MusaMahmood/KiCAD-EEG-INA828-nRF52/EEG_ADS1299.kicad_pcb

## KiCad design EEG_ADS1299.kicad_pcb (2018-03-07)

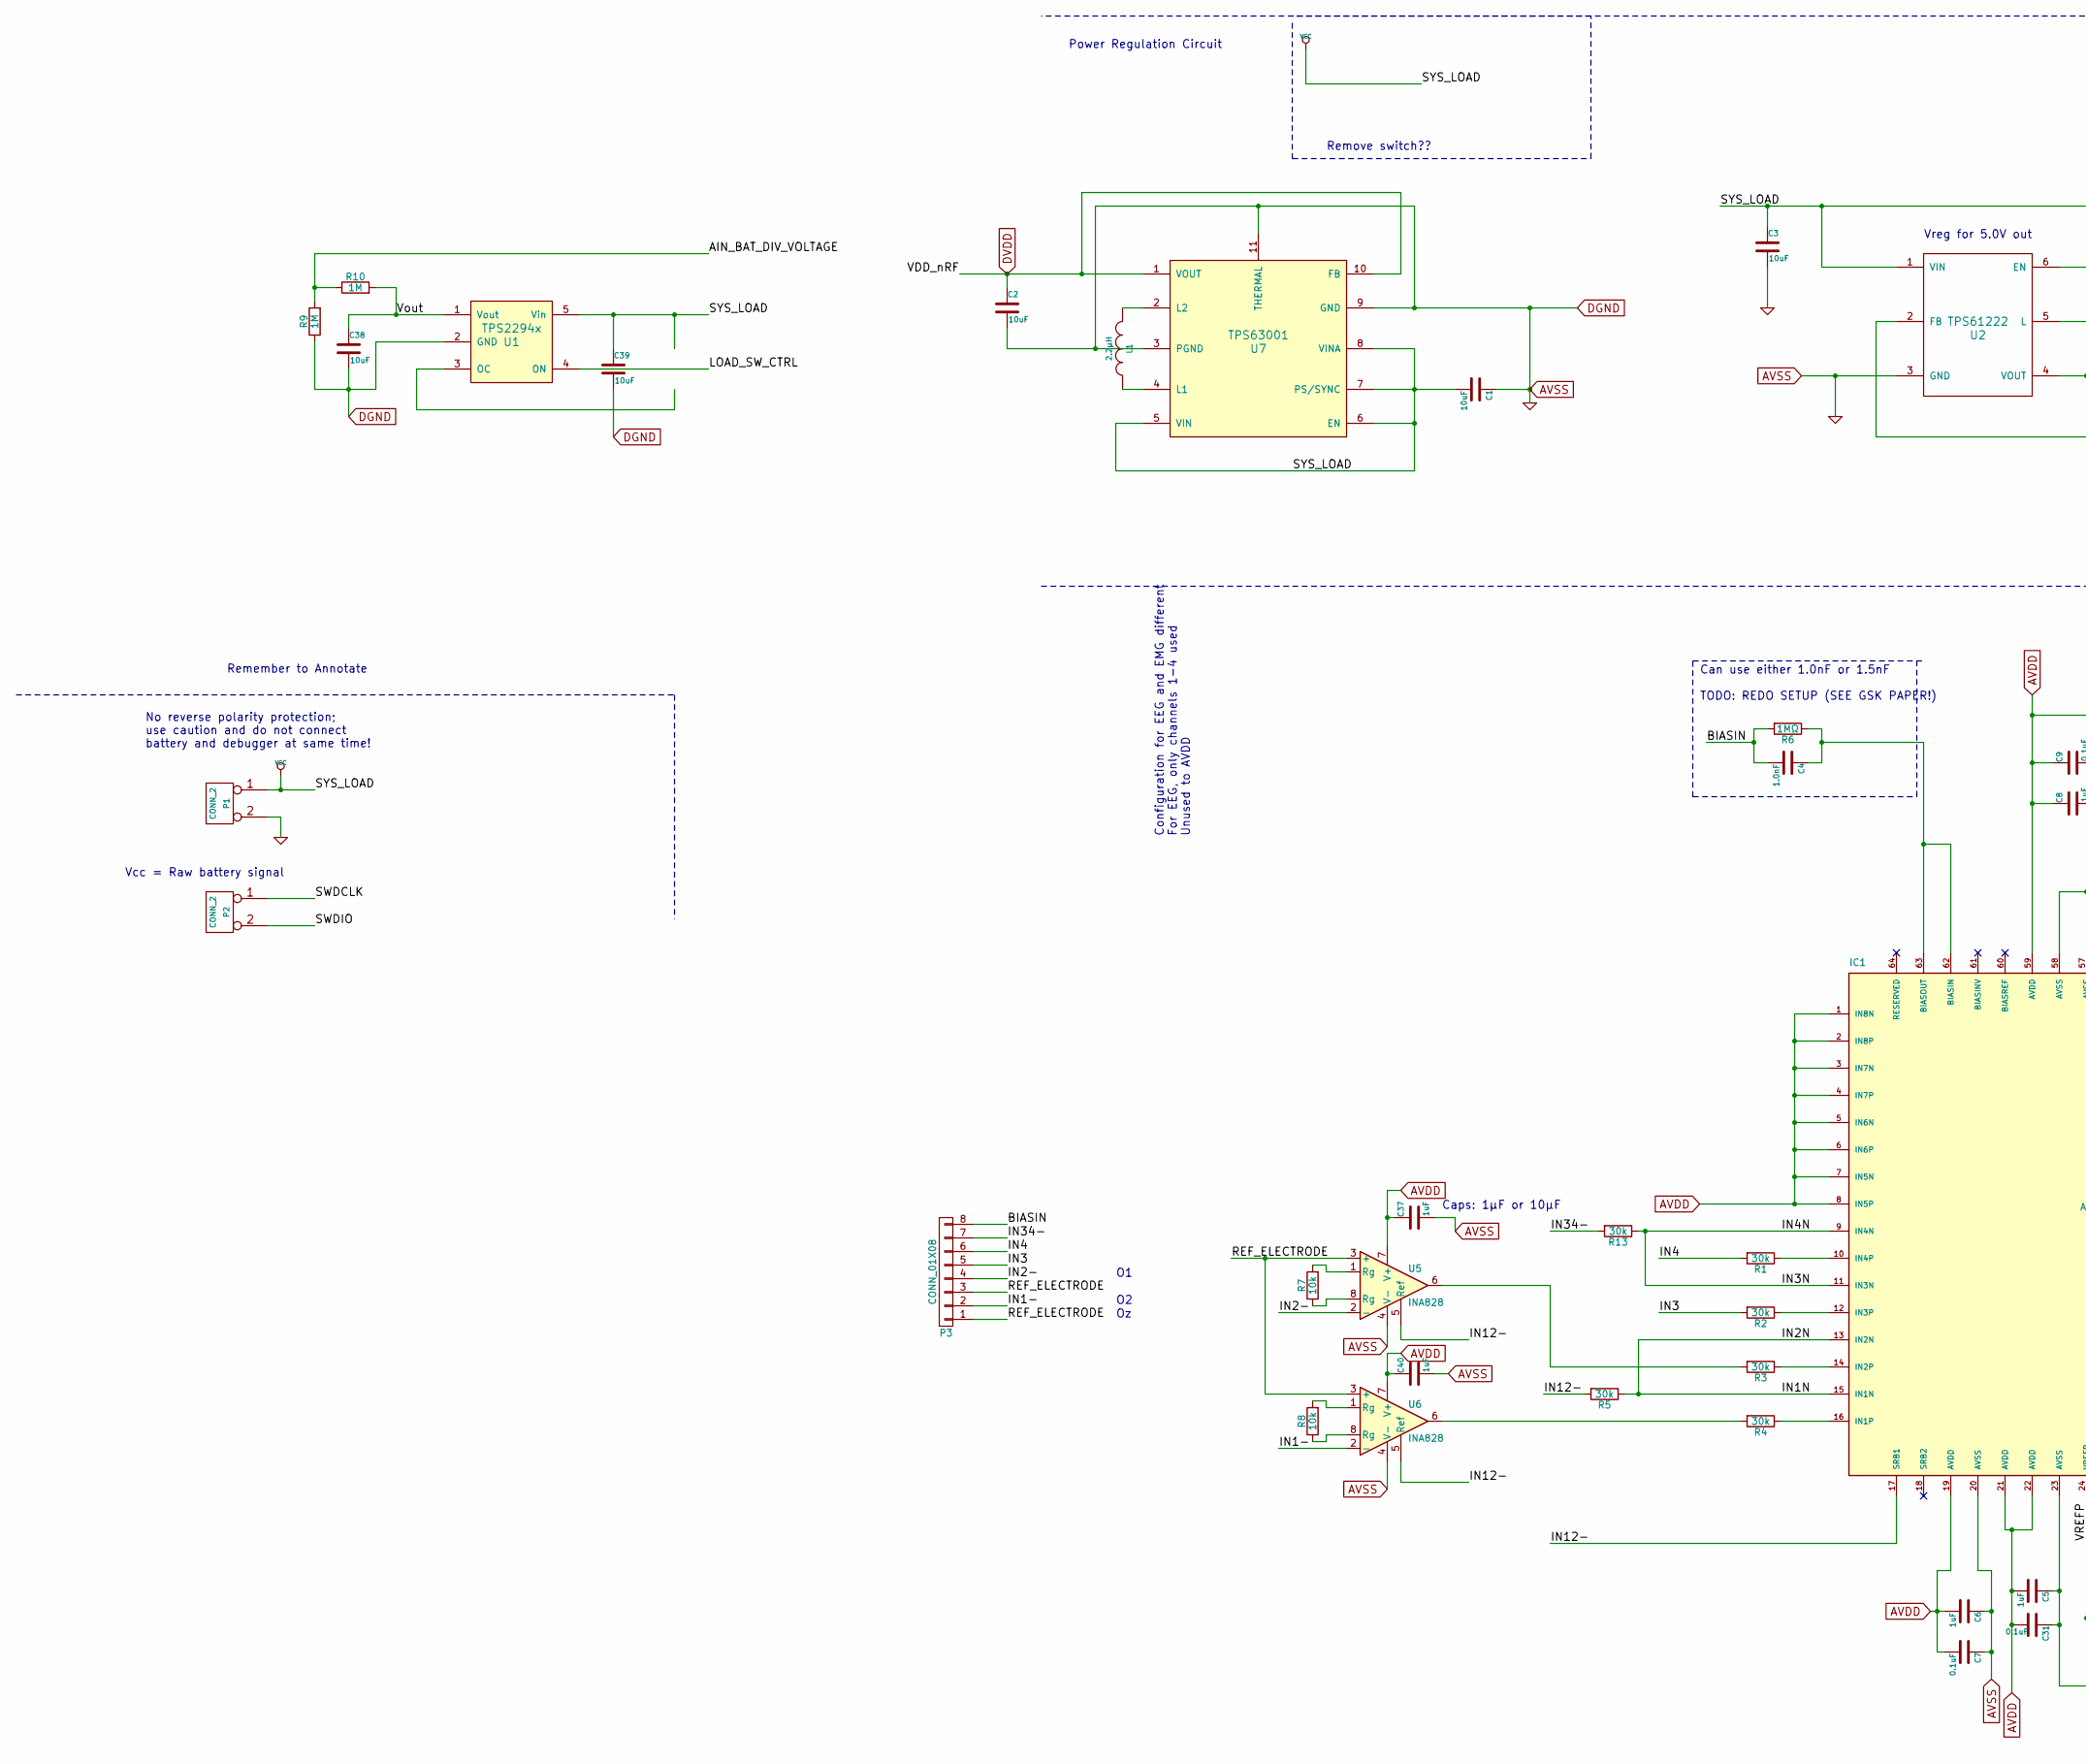
[picture p1: schematic EEG_ADS1299.sch, part in row 1, column 1]

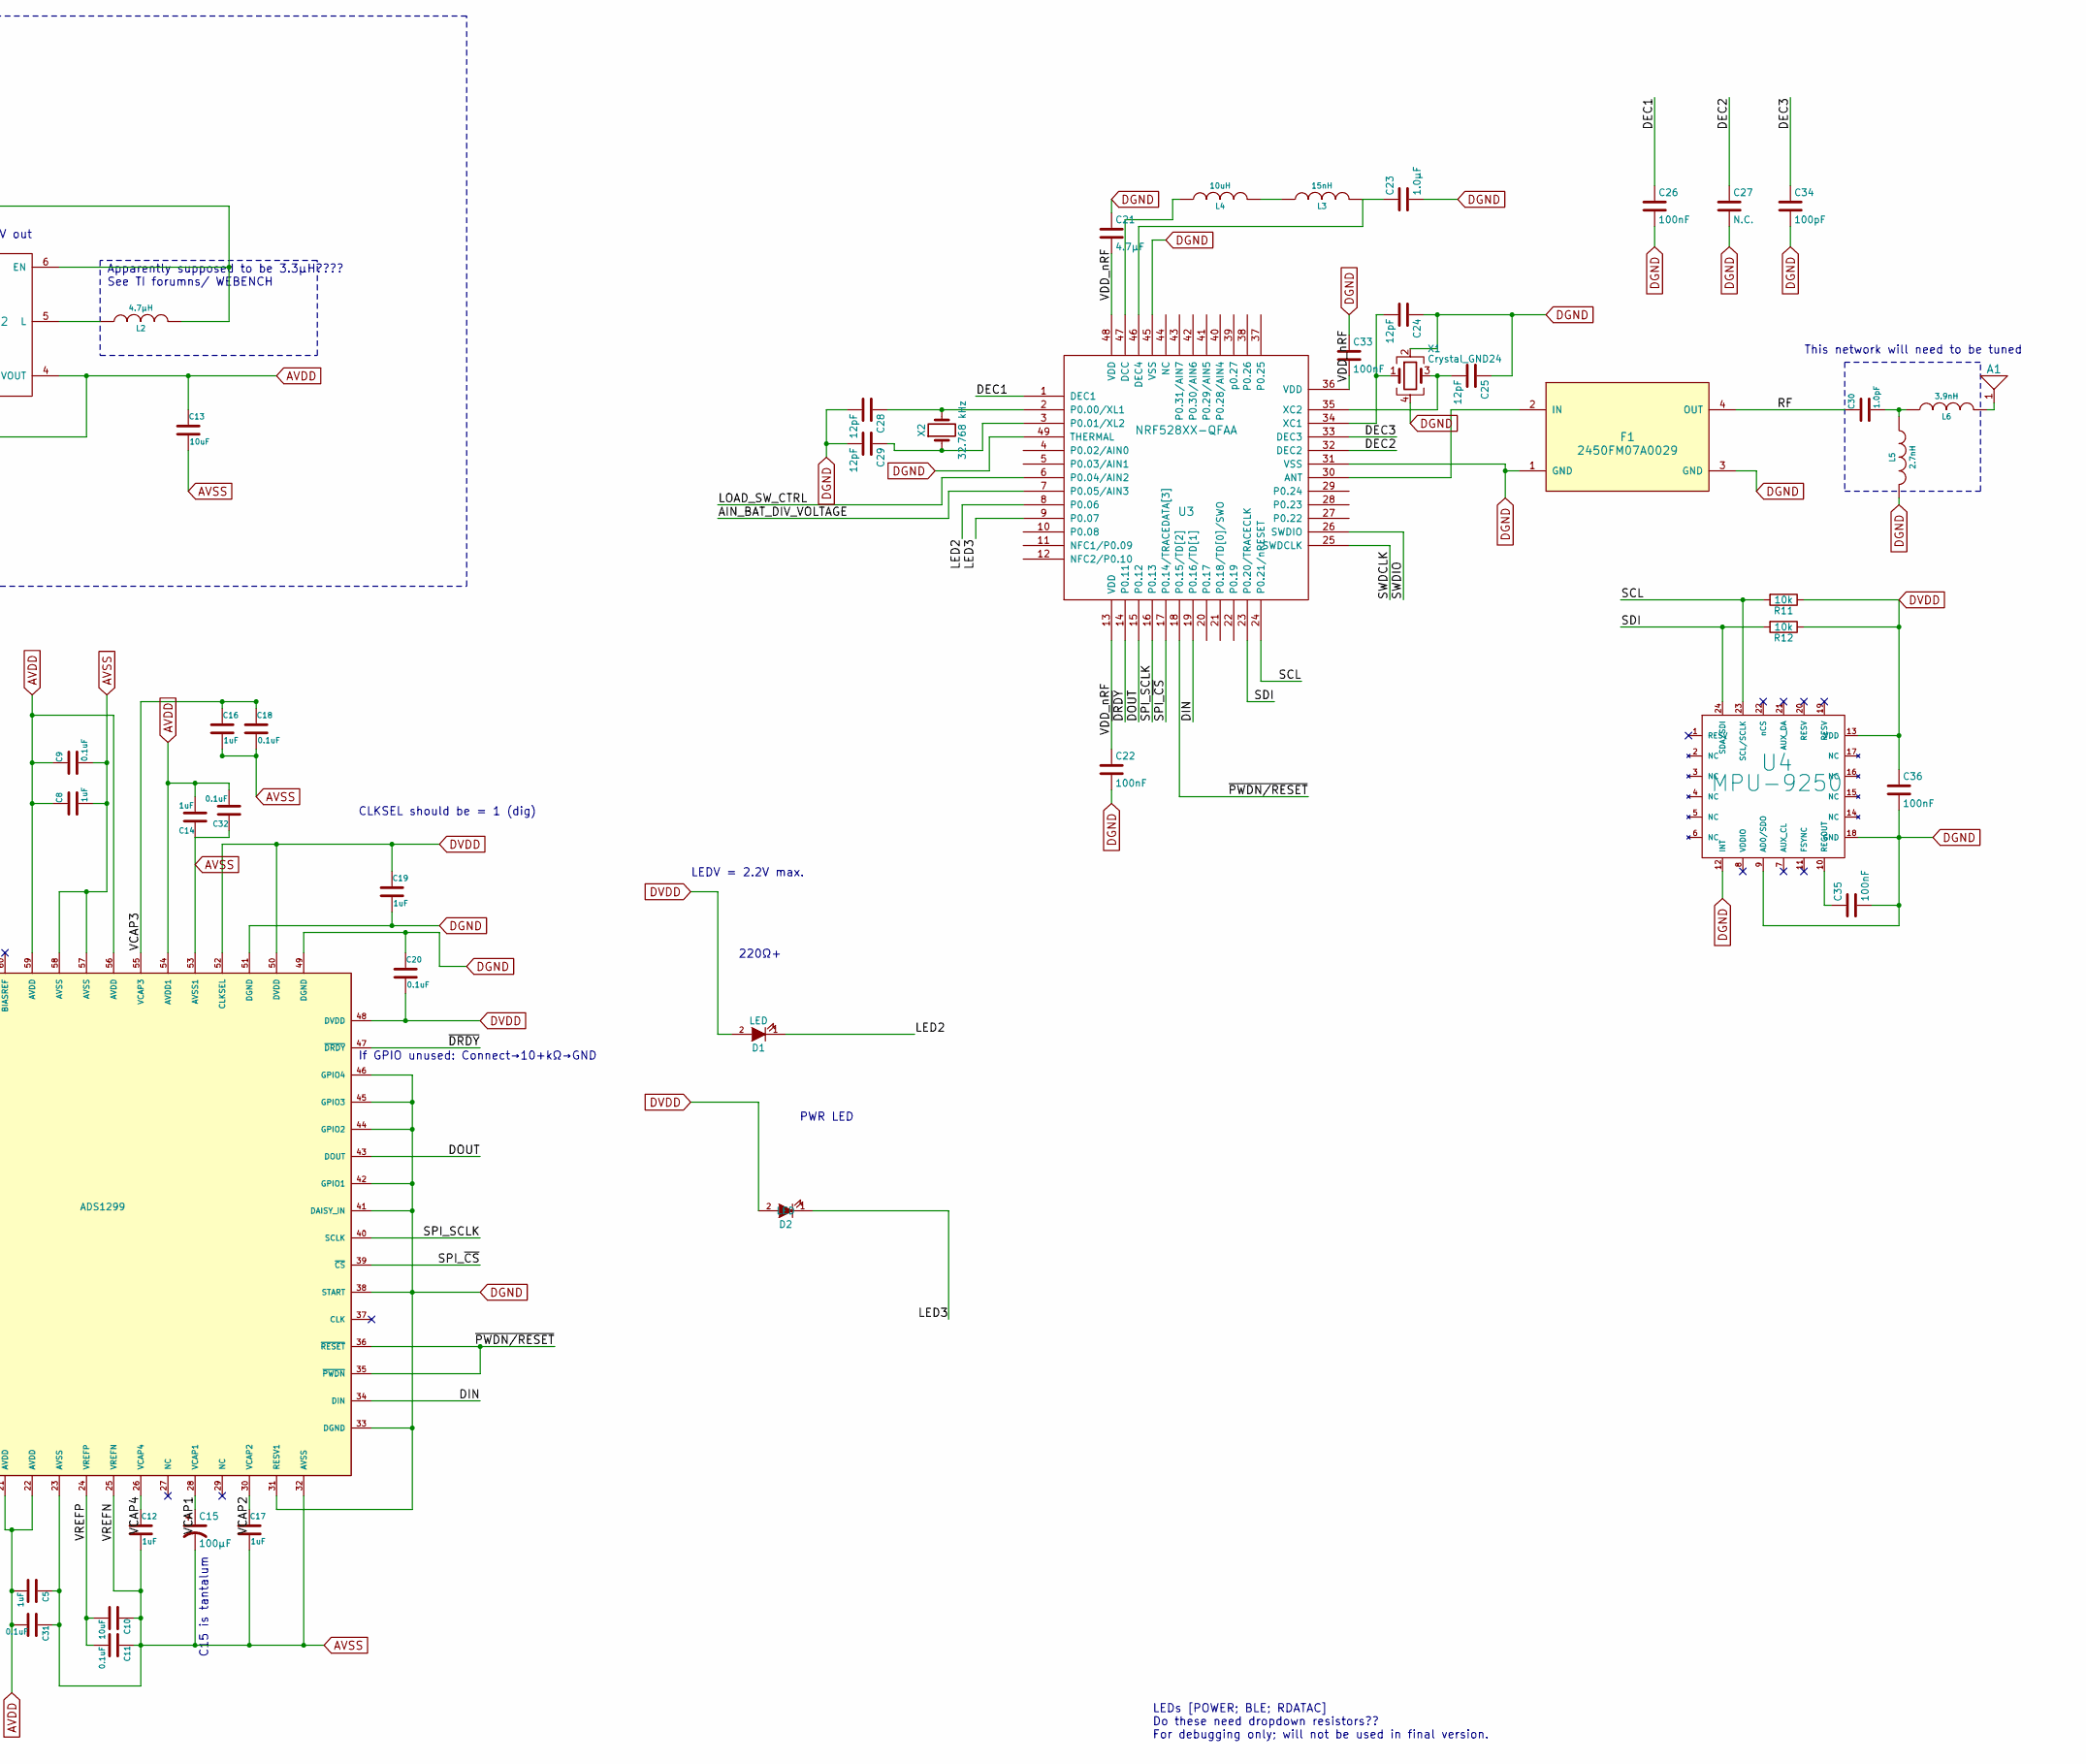
[picture p2: schematic EEG_ADS1299.sch, part in row 1, column 2]

Parts:
A1: CHIP-ANT
C1, C2, C3, C13, C38, C39: 10uF; C_0402
C4: 1.0nF; C_0402
C5, C6, C8, C12, C14, C16, C17, C19, C37, C40: 1uF; C_0402
C7, C9, C11, C18, C20, C31, C32: 0.1uF; C_0402
C10: 10uF; C_0603
C15: 100µF; C_0603
C21: 4.7µF; C_0402
C22: 100nF; C_0603
C23: 1.0µF; C_0603
C24, C25, C28, C29: 12pF; C_0402
C26, C33, C35, C36: 100nF; C_0402
C27: N.C.
C30: 1.0pF; C_0402
C34: 100pF; C_0402
D1, D2: LED; LED_0603
F1: 2450FM07A0029
IC1: ADS1299; TQFP-64_10x10mm_Pitch0.5mm
L1: 2.2µH; L_0603
L2: 4.7µH; L_0603
L3: 15nH; L_0402
L4: 10uH; L_0603
L5: 2.7nH; L_0402
L6: 3.9nH; L_0402
P1, P2: CONN_2; Pin_Header_Straight_1x02_Pitch2.54mm
P3: CONN_01X08
R1, R2, R3, R4, R5, R13: 30k; R_0402
R6: 1MΩ; R_0402
R7, R8, R11, R12: 10k; R_0402
R9, R10: 1M; R_0402
U1: TPS2294x; SOT-353_SC-70-5
U2: TPS61222; SOT-363_SC-70-6
U3: NRF528XX-QFAA; UQFN-48-1EP_6x6mm_Pitch0.4mm
U4: MPU-9250; QFN-24_3x3mm_Pitch0.4mm
U5, U6: INA828; SOIC_8_4.9mm_x_3.91
U7: TPS63001; DFN-10-1EP_3x3mm_Pitch0.5mm
X1: Crystal_GND24; Crystal_SMD_2016-4pin_2.0x1.6mm
X2: 32.768 kHz; Crystal_SMD_2012-2pin_2.0x1.2mm

Connections:
/AIN_BAT_DIV_VOLTAGE: R9.2, R10.1, U3.7 (P0.05/AIN3)
/BIASIN: C4.2, P3.8, R6.2
/DEC1: C26.1, U3.1 (DEC1)
/DEC2: C27.1, U3.32 (DEC2)
/DEC3: C34.1, U3.33 (DEC3)
/DIN: IC1.34 (DIN), U3.19 (P0.16/TD[1])
/DOUT: IC1.43 (DOUT), U3.15 (P0.12)
/IN1-: P3.2, U6.2 (-)
/IN1N: IC1.13 (IN2N), IC1.15 (IN1N), R5.1
/IN2-: P3.4, U5.2 (-)
/IN3: P3.5, R2.2
/IN3N: IC1.9 (IN4N), IC1.11 (IN3N), R13.1
/IN4: P3.6, R1.2
/IN12-: IC1.17 (SRB1), R5.2, U5.5 (Ref), U6.5 (Ref)
/IN34-: P3.7, R13.2
/LED2: D1.1 (K), U3.8 (P0.06)
/LED3: D2.1 (K), U3.9 (P0.07)
/LOAD_SW_CTRL: U1.4 (ON), U3.6 (P0.04/AIN2)
/REF_ELECTRODE: P3.1, P3.3, U5.3 (+), U6.3 (+)
/RF: C30.1, F1.4 (OUT)
/SCL: R11.2, U3.24 (P0.21/nRESET), U4.23 (SCL/SCLK)
/SDI: R12.2, U3.23 (P0.20/TRACECLK), U4.24 (SDA/SDI)
/SPI_SCLK: IC1.40 (SCLK), U3.16 (P0.13)
/SPI_~CS: IC1.39 (~CS), U3.17 (P0.14/TRACEDATA[3])
/SWDCLK: P2.1, U3.25 (SWDCLK)
/SWDIO: P2.2 (PM), U3.26 (SWDIO)
/VCAP1: C15.1, IC1.28 (VCAP1)
/VCAP2: C17.1, IC1.30 (VCAP2)
/VCAP3: C16.1, C18.1, IC1.55 (VCAP3)
/VCAP4: C12.1, IC1.26 (VCAP4)
/VREFP: C10.2, C11.2, IC1.24 (VREFP)
/Vout: C38.1, R10.2, U1.1 (Vout)
/~DRDY: IC1.47 (~DRDY), U3.14 (P0.11)
/~PWDN/RESET: IC1.35 (~PWDN), IC1.36 (~RESET), U3.18 (P0.15/TD[2])
AVDD: C5.2, C6.2, C7.2, C8.1, C9.1, C13.1, C14.2, C31.2, C32.2, C37.1, C40.1, IC1.1 (IN8N), IC1.2 (IN8P), IC1.3 (IN7N), IC1.4 (IN7P), IC1.5 (IN6N), IC1.6 (IN6P), IC1.7 (IN5N), IC1.8 (IN5P), IC1.19 (AVDD), IC1.21 (AVDD), IC1.22 (AVDD), IC1.54 (AVDD1), IC1.56 (AVDD), IC1.59 (AVDD), U2.2 (FB), U2.4 (VOUT), U5.7 (V+), U6.7 (V+)
AVSS: C1.1, C2.2, C3.2, C5.1, C6.1, C7.1, C8.2, C9.2, C10.1, C11.1, C12.2, C13.2, C14.1, C15.2, C16.2, C17.2, C18.2, C19.2, C20.1, C21.1, C22.2, C23.2, C24.1, C25.1, C26.2, C27.2, C28.2, C29.2, C31.1, C32.1, C33.1, C34.2, C35.2, C36.2, C37.2, C38.2, C39.2, C40.2, F1.1 (GND), F1.3 (GND), IC1.20 (AVSS), IC1.23 (AVSS), IC1.25 (VREFN), IC1.31 (RESV1), IC1.32 (AVSS), IC1.33 (DGND), IC1.38 (START), IC1.41 (DAISY_IN), IC1.42 (GPIO1), IC1.44 (GPIO2), IC1.45 (GPIO3), IC1.46 (GPIO4), IC1.49 (DGND), IC1.51 (DGND), IC1.53 (AVSS1), IC1.57 (AVSS), IC1.58 (AVSS), L5.2, P1.2 (PM), R9.1, U1.2 (GND), U2.3 (GND), U3.31 (VSS), U3.45 (VSS), U3.49 (THERMAL), U4.9 (AD0/SDO), U4.12 (INT), U4.18 (GND), U5.4 (V-), U6.4 (V-), U7.3 (PGND), U7.9 (GND), U7.11 (THERMAL), X1.2, X1.4
DVDD: C2.1, C19.1, C20.2, C21.2, C22.1, C33.2, C36.1, D1.2 (A), D2.2 (A), IC1.48 (DVDD), IC1.50 (DVDD), IC1.52 (CLKSEL), R11.1, R12.1, U3.13 (VDD), U3.36 (VDD), U3.48 (VDD), U4.13 (VDD), U7.1 (VOUT), U7.10 (FB)
unnamed: A1.1 (ANT), L6.2
unnamed: C4.1, IC1.62 (BIASIN), IC1.63 (BIASOUT), R6.1
unnamed: C23.1, L3.2, U3.46 (DEC4)
unnamed: C24.2, U3.34 (XC1), X1.1
unnamed: C25.2, U3.35 (XC2), X1.3
unnamed: C28.1, U3.2 (P0.00/XL1), X2.2
unnamed: C29.1, U3.3 (P0.01/XL2), X2.1
unnamed: C30.2, L5.1, L6.1
unnamed: C35.1, U4.10 (REGOUT)
unnamed: F1.2 (IN), U3.30 (ANT)
unnamed: IC1.10 (IN4P), R1.1
unnamed: IC1.12 (IN3P), R2.1
unnamed: IC1.14 (IN2P), R3.1
unnamed: IC1.16 (IN1P), R4.1
unnamed: L1.1, U7.4 (L1)
unnamed: L1.2, U7.2 (L2)
unnamed: L2.1, U2.5 (L)
unnamed: L3.1, L4.2
unnamed: L4.1, U3.47 (DCC)
unnamed: R3.2, U5.6
unnamed: R4.2, U6.6
unnamed: R7.1, U5.8 (Rg)
unnamed: R7.2, U5.1 (Rg)
unnamed: R8.1, U6.8 (Rg)
unnamed: R8.2, U6.1 (Rg)
VCC: C1.2, C3.1, C39.1, L2.2, P1.1, U1.5 (Vin), U2.1 (VIN), U2.6 (EN), U7.5 (VIN), U7.6 (EN), U7.7 (PS/SYNC), U7.8 (VINA)

Notes on the sheet:
This network will need to be tuned
No reverse polarity protection; use caution and do not connect battery and debugger at same time!
Can use either 1.0nF or 1.5nF TODO: REDO SETUP (SEE GSK PAPER!)
Configuration for EEG and EMG different For EEG, only channels 1-4 used Unused to AVDD
Remember to Annotate
If GPIO unused: Connect→10+kΩ→GND
Vreg for 5.0V out
LEDs [POWER; BLE; RDATAC] Do these need dropdown resistors?? For debugging only; will not be used in final version.
Power Regulation Circuit
Vcc = Raw battery signal
CLKSEL should be = 1 (dig)
C15 is tantalum
Apparently supposed to be 3.3µH???? See TI forumns/ WEBENCH
Remove switch??
220Ω+
LEDV = 2.2V max.
PWR LED
Caps: 1µF or 10µF

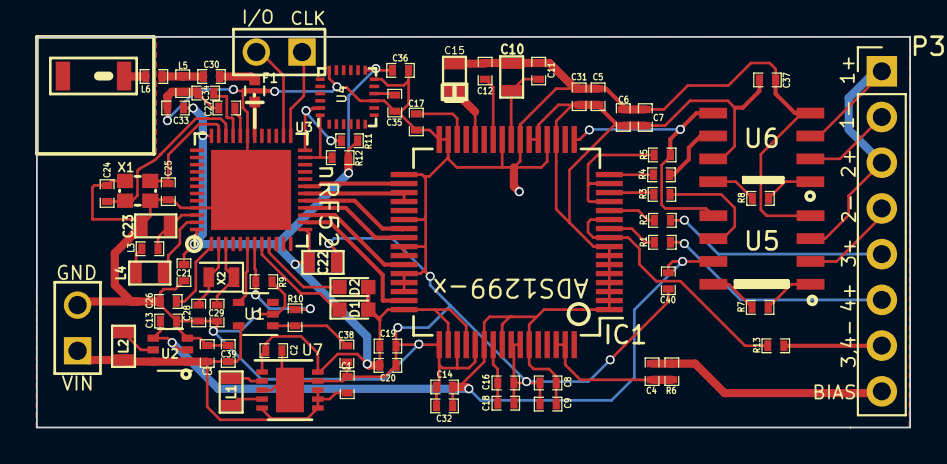
[picture p3: board EEG_ADS1299.kicad_pcb from above]

Board: 2 copper layers, 48.5 x 21.7 mm, 76 parts (0 on the bottom side), 63 nets.
