MusaMahmood/KiCAD-EEG-INA828-nRF52/(threads)

Thread 1 (2017-12-06):

Missing input capacitor on power supply

MusaMahmood, 2017-12-06:
Between AVDD and AVSS. 0.1µF to 10µF cap.

MusaMahmood, 2017-12-12:
Fixed in #1, and #4

Closed 2017-12-12.

Thread 2 (2017-12-09):

High input noise level - need to determine correct circuit configuration

MusaMahmood, 2017-12-09:
Experiment with circuit configuration using an ECG input signal.

MusaMahmood, 2017-12-12:
Fixed in pull #4 .

Closed 2017-12-12.
