MusaMahmood/KiCAD-EEG-INA828-nRF52/(commit log)

2017-12-04 Reorganized libraries into 'libs/' folder, footprint associations, fixed schematic.
    [EEG_ADS1299.kicad_pcb, EEG_ADS1299.sch]
2017-12-04 Updated schematic, deleted extra pin headers. Removed extra components from pcb file.
    [EEG_ADS1299.kicad_pcb, EEG_ADS1299.sch]
2017-12-04 Finished pcb draft for 4-ch with 2x INA828 (single-ended only).
    [EEG_ADS1299.kicad_pcb, EEG_ADS1299.sch]
2017-12-04 Updated gerber files.
    [EEG_ADS1299-B.Cu.gbl, EEG_ADS1299-B.Mask.gbs, EEG_ADS1299-B.SilkS.gbo, EEG_ADS1299-Edge.Cuts.gm1, EEG_ADS1299-F.Cu.gtl, EEG_ADS1299-F.Mask.gts, EEG_ADS1299-F.SilkS.gto, EEG_ADS1299.drl]
2017-12-06 (#1) - Added single capacitor on amp inputs. (C37)
    [EEG_ADS1299.kicad_pcb, EEG_ADS1299.sch]
2017-12-12 Added TPS63001, TPS22941.
    [EEG_ADS1299.kicad_pcb, EEG_ADS1299.sch]
2017-12-12 Fixed design and separated channels 1 and 2 from 3 and 4, with 1 and 2 being the pre-amplified circuits.
    [EEG_ADS1299.kicad_pcb, EEG_ADS1299.sch]
2017-12-13 Updated front mask for correct information + gerber files for v3.2
    [EEG_ADS1299-B.Cu.gbl, EEG_ADS1299-B.Mask.gbs, EEG_ADS1299-B.SilkS.gbo, EEG_ADS1299-Edge.Cuts.gm1, EEG_ADS1299-F.Cu.gtl, EEG_ADS1299-F.Mask.gts, EEG_ADS1299-F.SilkS.gto, EEG_ADS1299.drl]
2017-12-13 Fixed #5, and fixed back silkscreen.
    [EEG_ADS1299-B.Cu.gbl, EEG_ADS1299-B.Mask.gbs, EEG_ADS1299-B.SilkS.gbo, EEG_ADS1299-Edge.Cuts.gm1, EEG_ADS1299-F.Cu.gtl, EEG_ADS1299-F.Mask.gts, EEG_ADS1299-F.SilkS.gto, EEG_ADS1299.drl]
2018-03-07 Updated schematic and pcb design to reflect final EEG design: Connected SRB1 to IN12-.
    [EEG_ADS1299.kicad_pcb, EEG_ADS1299.sch]
